BoomerChiao/STM32_business_card/README.md

# STM32_business_card
STM32G030-based electronic business card with SHT40 sensor and OLED display for basic temperature and humidity monitoring.

此電子名片採用 STM 架構完成功能，內部預設 SHT40 和 OLED 顯示螢幕電路布局，可輕鬆實現即時溫溼度量測功能。

##  Summary　（概要）
STM32 business card 是由 STMicroelectronics 旗下的 STM32G030 系列微控制器為核心設計的開發板。

在整體電路設計中，整合了 SHT40 高精度溫溼度感測器，以用於監測周遭環境的溫度和濕度變化。此外，確保量測數據能即時更新，同時搭載一片 OLED 顯示面板，可將即時感測到的數據清晰呈現，方便使用者隨時掌握環境狀態。

##  Installation　（安裝）
安裝 STM32CubeIDE 軟體
- STM32CubeIDE 軟體下載：https://www.st.com/en/development-tools/stm32cubeide.html
- (非必要) STM32CubeProg 軟體下載：https://www.st.com/en/development-tools/stm32cubeprog.html



##  Import data　（導入資料）
1. 下載 GitHub 資料 code 專案：
   - 你可以從本網的 GitHub 下載所需的資料，或是自行創建一個新的 STM32 專案。

     你可以在這裡下載檔案：https://github.com/BoomerChiao/STM32_business_card/tree/main/STM32_code
    
2. 導入至STM32程式函數庫：
   - 以下將提供 3 種導入方式
      1. File → Import → General → Existing Projects into Workspace → Next，在 Select root directory 選擇專案資料夾，勾選找到的專案，然後按 Finish。
      2. File → Import → General → Archive File，選擇.zip 專案檔 → CubeIDE 就會自動幫你解壓並辨識，然後按 Finish。
      3. 解壓縮.zip 專案檔，直接點擊.project檔案。
         
4. 完成STM32導入後：
   - 點擊左側IDE專案，選擇STM32_SHT40xOLED.ioc檔案雙擊兩下開啟。
   - .ioc檔開啟後，點擊上面欄位🔨符號，確認配置偵錯是否可以跑。
   - 偵錯跑完無錯誤，則導入專案成功。
  
   

##  Prepare Electronic Materials　（準備電子材料）
1. ST-LINK/V2
2. STM32G030F6P6 Mini Development or STM32G030F6P6 
3. 0.96' OLED Display 128×64 4Pin IIC I2C
4. SHT40 (3.3V)
5. button switch 4 pin 6×6×4.5mm *2
6. Jumper Wires



##  Pin wiring　（引腳接線）
以下提供基礎引腳接線方式，請依據你的成品需求進行接線。

下圖分別展示 OLED Display 與 SHT40 的接線方式。
- 請注意，該板子設計僅持支援 3V 電壓範圍。因此，建議將 VCC 預設為 3V 電源以確保正常運作。
- STM32G030F6P6 Mini Development: PC14 (SDA) ; PB7 (SCL) ; PB3 (Switch A) ; PC15 (Switch B)
- SHT40: SDA (PC14) ; SCL (PB7)
- OLED Display: SDA (PC14) ; SCL (PB7)
- Switch A: A (GND) ; B (PB3)
- Switch B: A (GND) ; B (PC15)







##  Programming STM32 with firmware　（STM32程式代碼燒入）
1. 工具準備🔧：
   - ST-LINK V2 (或相容版本)。
   - 4 根杜邦線。
   - STM32 開發板或晶片。
    
2. 硬體接線 (SWD 模式)⚡：
   -  USB_VDD(3.3V) → 3.3V
   -  USB_GND → GND
   -  USB_SWDIO → DIO(A13)
   -  USB_SWCLK → CLK(A14)

4. 軟體燒錄📥：
   -  安裝並打開 STM32CubeIDE。
   -  開啟需要燒入專案。
   -  插入 ST-LINK V2 USB。
   -  按下「Run」◀️ 或「Debug」🐞 就能直接下載程式。
  
##  Software Presentation　（成品展示）
### OLED畫面


- 上圖為主畫面，提供溫度及濕度和最高溫與最低溫相關資訊。
   -  溫度計符號「🌡️」為 攝氏溫度。
   -  水滴符號「💧」為 濕度。
   -  Temp 下面「H」英文為high，專門紀錄目前探測到最高溫度；而「L」英文為low，負責記錄目前探測到最低溫度。



- 上圖為子畫面，提供最基本溫度及濕度顯示。

### OLED顯示功能與視覺效果
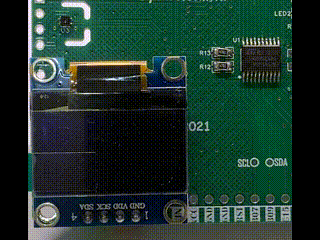
[picture p1: JPG/OLED_DISPLAY.gif]
OLED Demo


- 上圖子母畫面正常運轉情況下，亮4秒，滅14秒。

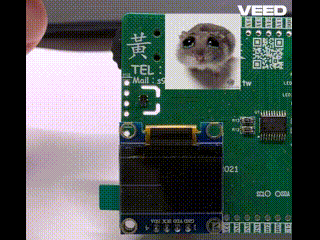
[picture p2: JPG/OLED_TOOL_A.gif]
OLED Demo


- 當負責 PC15 按鈕被觸發時，系統將進入切換 SLEEP 或 NORMAL 畫面；若畫面處於熄滅的狀況下，則會自動喚醒。

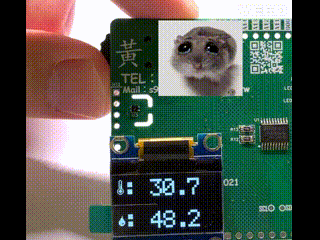
[picture p3: JPG/OLED_TOOL_B.gif]
OLED Demo


- 當負責 PB3 按鈕被觸發時，系統將進入切換子母畫面；若畫面處於熄滅的狀況下，則會自動喚醒。

##  Advanced Design　（進階設計）
這是由超可愛寶寶的超可愛帥氣男友兼未來老公的吉吉阿奇爸爸所設計，上面有可愛吉吉商標設計。
為了製作卡片型態的 MCU 開發板，我們必需採用 PCB 印刷技術，可適當加入個人資訊，以得到具個性化的卡片設計。

您可在此下載 Gerber 檔案，並上傳至 JLCPCB 進行 PCB 訂製
- Gerber：https://github.com/BoomerChiao/STM32_business_card/tree/main/PCB
- JLCPCB：https://jlcpcb.com/

您也可在此下載原理圖及 PCB 檔案，以進行後續編輯。
- oshwlab：

###  Circuit Design （電路設計）


- 左側 MCU 採用 STM32G 系列晶片，並選擇 TSSOP20 封裝，便於手工焊接完成。
- USB 供電部分採用 HT7333-3 LDO 穩壓器，具備低功耗特性，同時也支援較高電壓輸入，方便各式電壓源輸入。
- 主感測器晶片選擇使用 Sensirion SHT40 ，低功耗溫濕度感測器，該感測器已廣泛應用在市售設備中，具備一定高穩定性；而副感測器則採用 DS18B20 。



- 備用電源則使用 CR2032 鈕扣電池作為攜帶式備用電源，確保在無 USB 供電情況下仍能可使用其他方案供電。
- 互動式按鈕則採用 Rotary Wheel Switch ，取代傳統按鈕設計，提供更方便操作體驗。

###  PCB layout （電路布局）


###  PCB Prepare Electronic Materials　（PCB準備電子材料）
1. SMD MLCC 
   - C1、C4、C5、C6、C7：100nF-1206 or N/A 
   - C2、C3：10uF-1206

2. SMD Resistors
   - R1、R2、R3、R4、R5、R6、R7、R8、R15、R16：0Ω-0805
   - R9、R17、R18：10kΩ-0805
   - R10、R11：1kΩ-0805
   - R12、R13、R14：4.7kΩ-0805 or N/A

3. SMD Active component
   - D1、D3：1N4007 or M7
   - U1：STM32G030F6P6TR or STM32G031F8P6
   - U2：HT7333-3 (SOT89)
   - U3：SHT40
   - U4：DS18B20 or N/A
  
4. SMD LED
   - LED1、LED2：LED-1206 (XL-3216UGC)

5. Button switch 
   - SW1：(DIP) button switch 4 pin 6×6×4.5mm
   - U5：(SMD) XUNPU QS-301-AGS5P

6. DIP and SMD Connectors 
   - H1、H2：DIP 2.54mm Plugin 1x12P Pin Headers (HB-PH3-254112PB2GOP)
   - H3、H12、H15：DIP 2.54mm Plugin 1x4P Pin Headers (HB-PH3-25414PB2GOP)
   - H5：DIP 2.54mm Plugin 1x2P Pin Headers (PZ254V-11-02P)
   - H4、H6、H7：DIP 2.54mm Plugin 1x4P Female Headers (BX-PM2.54-1-4PY)
   - H8、H9、H10：SMD CONN HEADER 4POS 2.54mm SINGLE ROW SMD (X6511WVS-04H-C60D48R1) or N/A
   - H11：SMD CONN HEADER 8POS 2.54mm SINGLE ROW SMD (X6511WVS-08H-C60D48R2) or N/A
   - H13：N/A
   - H14：DIP 2.54mm Plugin 3P Straight 1x3P Pin Headers or 3P slide switch (BX-PZ2.54-1-3PZZ) or (3Pin Slide Switches-SPDT)

7. Power Connector
   - BT1：Q&J CR2032 3V
