BoomerChiao/STM32_business_card/JPG/IMG_9635.jpg

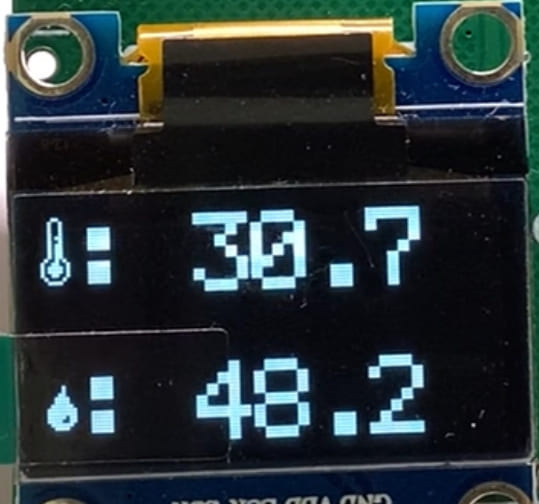
JPG/IMG_9635.jpg
