BoomerChiao/STM32_business_card/JPG/IMG_9636.jpg

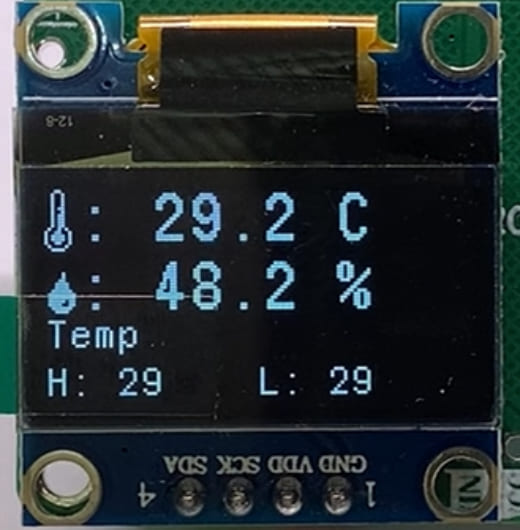
JPG/IMG_9636.jpg
