BoomerChiao/STM32_business_card/JPG/PCBL-A.png

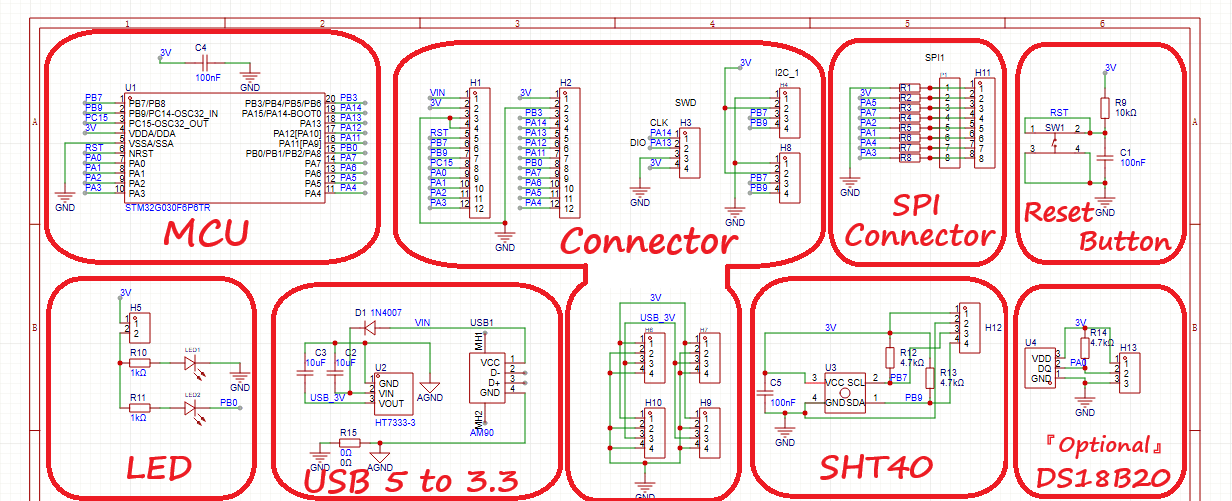
JPG/PCBL-A.png
