BoomerChiao/STM32_business_card/JPG/PCBL-B.png

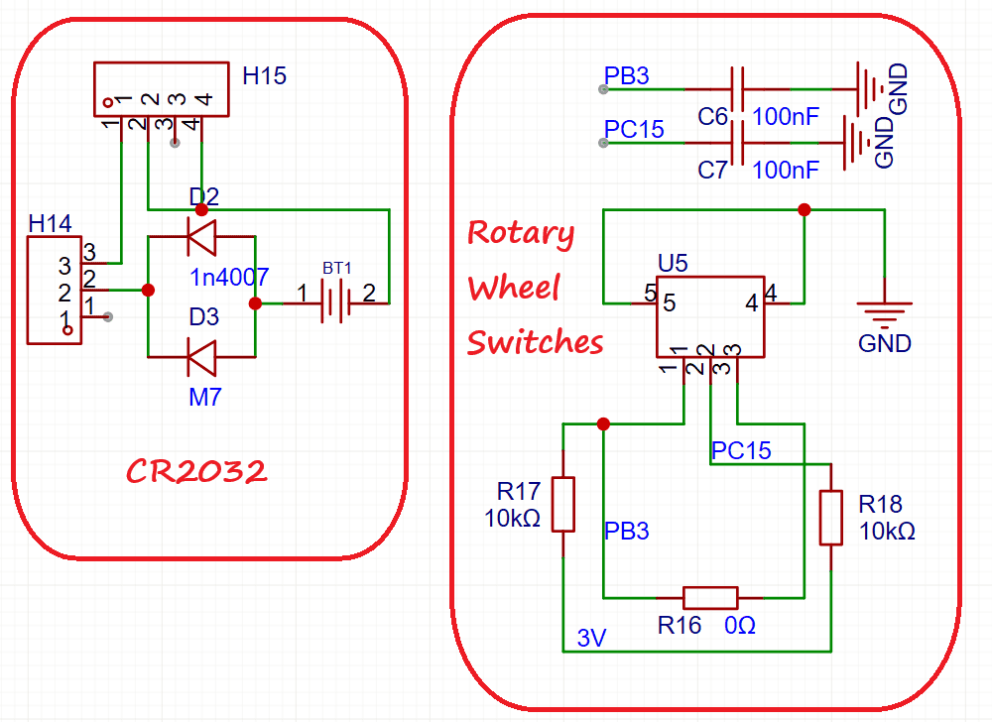
JPG/PCBL-B.png
