BoomerChiao/STM32_business_card/JPG/PCBL-C.png

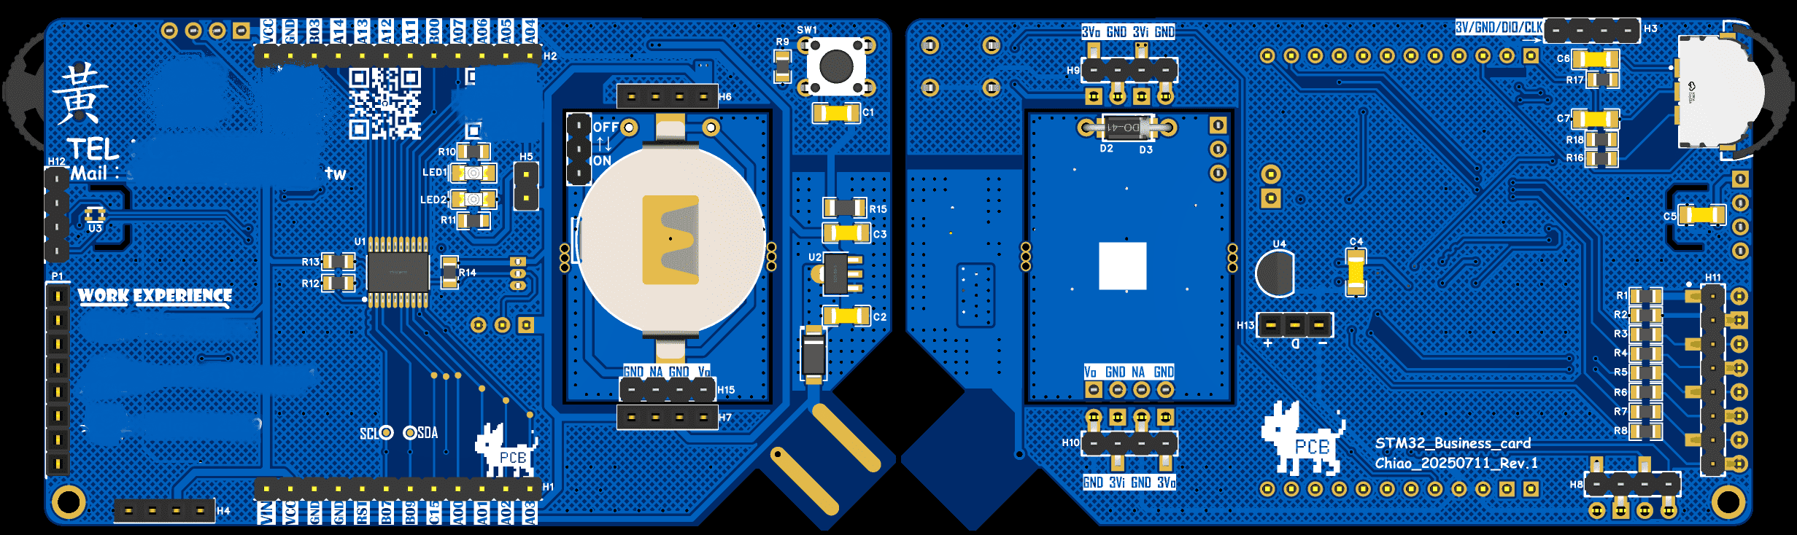
JPG/PCBL-C.png
