BoomerChiao/STM32_business_card/JPG/STM32_IDE.png

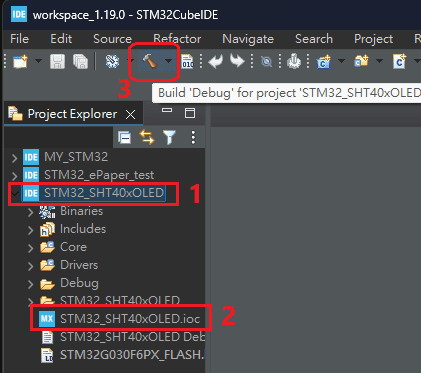
JPG/STM32_IDE.png
