BoomerChiao/STM32_business_card/JPG/STM32_OLED_Table.png

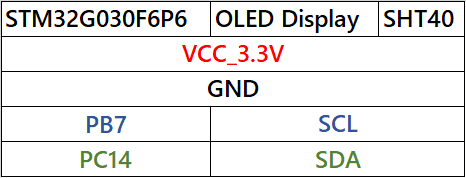
JPG/STM32_OLED_Table.png
