BoomerChiao/STM32_business_card/JPG/STM32_Table.png

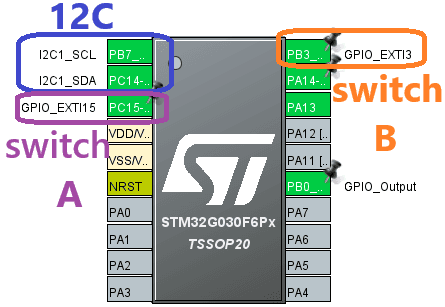
JPG/STM32_Table.png
