BoomerChiao/STM32_business_card/JPG/STM32xSHT40xOLEDxV2xSW.png

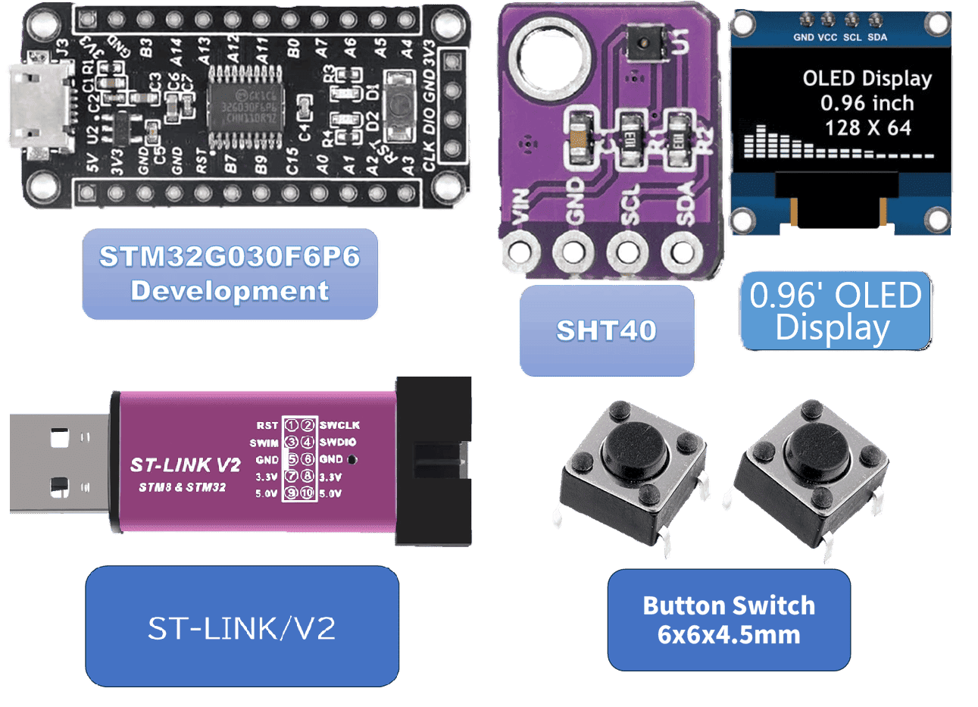
JPG/STM32xSHT40xOLEDxV2xSW.png
