BoomerChiao/STM32_business_card/STM32_code/STM32_SHT40xOLED/STM32_SHT40xOLED.ioc

Mcu.UserName=STM32G030F6Px
PA13.Signal=SYS_SWDIO
PA14-BOOT0.Signal=SYS_SWCLK
PB0.Signal=GPIO_Output
PB3.Signal=GPXTI3
PB8.Signal=I2C1_SCL
PB9.Signal=I2C1_SDA
