BoomerChiao/STM32_business_card/(notices)

Notices in the files:
STM32_code/STM32_SHT40xOLED/Core/Src/main.c:
Copyright (c) 2025 STMicroelectronics.
All rights reserved.
This software is licensed under terms that can be found in the LICENSE file
